bolshoydrug1/Remote_fly_ctrl/BOM_Remote_ctrl.xlsx

Reference | Qty | Value | DNP | Exclude from BOM | Exclude from Board | Footprint | Datasheet
C1 | 1 | 100u |  |  |  | Capacitor_SMD:C_Elec_6.3x7.7
C2,C3,C4,C5,C6,C7,C8,C9,C10,C11,C12,C14,C21,C22,C23,C24,C25,C26,C27,C28,C29,C30,C31,C32,C33,C34,C35,C36,C37,C38,C39,C40,C41,C42,C43,C44,C45,C46,C47,C48 | 40 | 0.1u |  |  |  | Capacitor_SMD:C_0805_2012Metric_Pad1.18x1.45mm_HandSolder
C15,C16,C18,C20 | 4 | 15p |  |  |  | Capacitor_SMD:C_0805_2012Metric_Pad1.18x1.45mm_HandSolder
C17,C19 | 2 | 2.2u |  |  |  | Capacitor_SMD:C_0805_2012Metric_Pad1.18x1.45mm_HandSolder
D1,D5 | 2 | SS32 |  |  |  | Diode_SMD:D_SMA | https://www.vishay.com/docs/88751/ss32.pdf
D2,D4,D6,D7 | 4 | SMAJ5.0CA |  |  |  | Diode_SMD:D_SMA | https://www.littelfuse.com/media?itemid=75e32973-b177-4ee3-a0ff-cedaf1abdb93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
D3 | 1 | LED |  |  |  | LED_THT:LED_D3.0mm_Clear
D9,D10 | 2 | LED |  |  |  | LED_SMD:LED_0805_2012Metric_Pad1.15x1.40mm_HandSolder
D11,D12,D13,D14,D15,D16,D17,D18,D19,D20 | 10 | LED |  |  |  | LED_THT:LED_D3.0mm
DD1 | 1 | BMP280 |  |  |  | Package_LGA:Bosch_LGA-8_2x2.5mm_P0.65mm_ClockwisePinNumbering | https://ae-bst.resource.bosch.com/media/_tech/media/datasheets/BST-BMP280-DS001.pdf
F1,F2 | 2 | MF-MSMF110-2 |  |  |  | Fuse:Fuse_1812_4532Metric_Pad1.30x3.40mm_HandSolder
J1 | 1 | USB_B_Mini |  |  |  | Connector_USB:USB_Mini-B_Lumberg_2486_01_Horizontal
J2 | 1 | Conn_01x03_Pin |  |  |  | Connector_JST:JST_NV_B03P-NV_1x03_P5.00mm_Vertical
J3 | 1 | Conn_01x03_Pin |  |  |  | Connector_PinHeader_2.54mm:PinHeader_1x03_P2.54mm_Vertical | do not install !!!
J4 | 1 | Conn_01x02_Pin |  |  |  | Connector_PinHeader_2.54mm:PinHeader_1x02_P2.54mm_Vertical | do not install !!!
J6,J8 | 2 | Conn_01x04_Pin |  |  |  | Connector_PinSocket_2.54mm:PinSocket_1x04_P2.54mm_Vertical
J7 | 1 | Conn_01x06_Pin |  |  |  | Connector_Hirose:Hirose_DF13-06P-1.25DSA_1x06_P1.25mm_Vertical
J9 | 1 | Conn_01x02_Pin |  |  |  | Connector_Hirose:Hirose_DF13-02P-1.25DSA_1x02_P1.25mm_Vertical
Q1 | 1 | AO3400A |  |  |  | Package_TO_SOT_SMD:SOT-23 | http://www.aosmd.com/pdfs/datasheet/AO3400A.pdf
R1,R5,R31,R32,R33,R34,R35,R36,R37,R38,R39,R40,R41,R42 | 14 | 100 |  |  |  | Resistor_SMD:R_0805_2012Metric_Pad1.20x1.40mm_HandSolder
R2,R7,R10,R11 | 4 | 10k |  |  |  | Resistor_SMD:R_0805_2012Metric_Pad1.20x1.40mm_HandSolder
R3,R4,R14,R17,R18 | 5 | 0 |  |  |  | Resistor_SMD:R_0805_2012Metric_Pad1.20x1.40mm_HandSolder
R12,R13 | 2 | 330 |  |  |  | Resistor_SMD:R_0805_2012Metric_Pad1.20x1.40mm_HandSolder
R15,R16,R19,R20 | 4 | 3k |  |  |  | Resistor_SMD:R_0805_2012Metric_Pad1.20x1.40mm_HandSolder
R21,R22,R23,R24,R25,R26,R27,R28,R29,R30 | 10 | 220 |  |  |  | Resistor_SMD:R_0805_2012Metric_Pad1.20x1.40mm_HandSolder
SW1,SW2,SW3,SW4,SW5,SW6,SW7,SW8,SW9,SW10,SW11,SW12 | 12 | SW_Push |  |  |  | Button_Switch_THT:SW_PUSH_6mm
U1 | 1 | AMS1117-3.3 |  |  |  | Package_TO_SOT_SMD:SOT-223-3_TabPin2 | http://www.advanced-monolithic.com/pdf/ds1117.pdf
U2 | 1 | SRV05-4 |  |  |  | Package_TO_SOT_SMD:SOT-23-6 | http://www.onsemi.com/pub/Collateral/SRV05-4-D.PDF
U3 | 1 | CH32V303VCT6 |  |  |  | Package_QFP:LQFP-100_14x14mm_P0.5mm | https://static.chipdip.ru/lib/164/DOC045164022.pdf
U4 | 1 | Ai-Thinker-Ra-01 |  |  |  | RF_Module:Ai-Thinker-Ra-01-LoRa | http://wiki.ai-thinker.com/_media/lora/docs/c047ps01a1_ra-01_product_specification_v1.1.pdf
U5 | 1 | AT24C256 |  |  |  | Package_SO:SOIC-8_3.9x4.9mm_P1.27mm | https://www.onsemi.cn/PowerSolutions/document/CAT24C256-D.PDF
U6 | 1 | Ai-Thinker-Ra-01SH |  |  |  | RF_Module:Ai-Thinker-Ra-01-LoRa | http://wiki.ai-thinker.com/_media/lora/docs/c047ps01a1_ra-01_product_specification_v1.1.pdf
U7,U8 | 2 | ULN2003 |  |  |  | Package_SO:SO-16_3.9x9.9mm_P1.27mm | http://www.ti.com/lit/ds/symlink/uln2003a.pdf
VD1,VD2,VD3,VD4,VD5,VD6,VD7,VD8,VD9,VD10,VD11 | 11 | GSOT03C-E3-08 |  |  |  | Package_TO_SOT_SMD:SOT-23 | https://www.chipdip.ru/product/gsot03c-e3-08-ustroystvo-zaschity-ot-esd-zaschitnyy-umw-9001633932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
Y1 | 1 | X322525MQB4SI |  |  |  | Oscillator:Oscillator_SMD_Abracon_ASE-4Pin_3.2x2.5mm | https://cdn.promelec.ru/upload/items/2023/03/10/YSX321SL.pdf
Y2 | 1 | SMD03215C2 |  |  |  | Crystal:Crystal_SMD_3215-2Pin_3.2x1.5mm | https://www.chipdip.ru/product/kvartsevyy-rezonator-32.768-kgts-korpus-smd03215c2-8010532234
