bolshoydrug1/Remote_fly_ctrl/(list of files, drawings)

Other design files:
freerouting.dsn
