bolshoydrug1/Remote_fly_ctrl/Magister_work_v1.kicad_pcb

## KiCad design Magister_work_v1.kicad_pcb (2026-10-15)

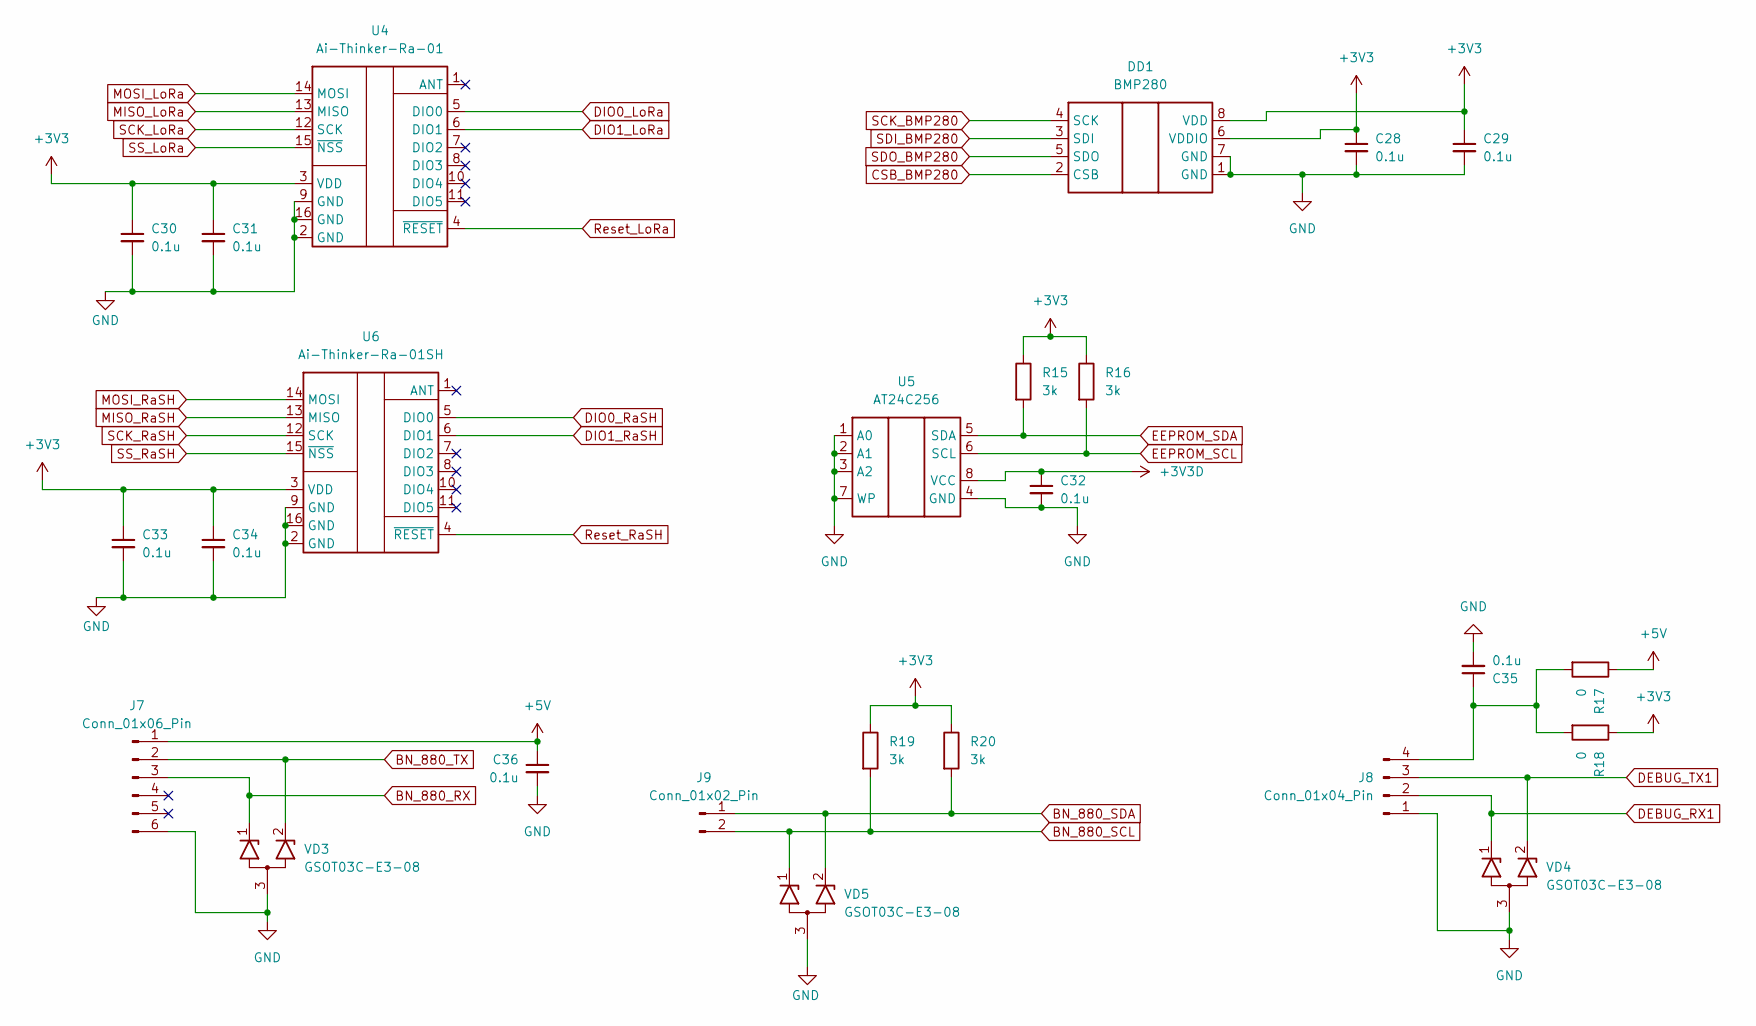
[picture p1: schematic Sensors_1.kicad_sch]

Parts:
C28, C29, C30, C31, C32, C33, C34, C35, C36: 0.1u; C_0805_2012Metric_Pad1.18x1.45mm_HandSolder
DD1: BMP280; Bosch_LGA-8_2x2.5mm_P0.65mm_ClockwisePinNumbering
J7: Conn_01x06_Pin; Hirose_DF13-06P-1.25DSA_1x06_P1.25mm_Vertical
J8: Conn_01x04_Pin; PinSocket_1x04_P2.54mm_Vertical
J9: Conn_01x02_Pin; Hirose_DF13-02P-1.25DSA_1x02_P1.25mm_Vertical
R15, R16, R19, R20: 3k; R_0805_2012Metric_Pad1.20x1.40mm_HandSolder
R17, R18: 0; R_0805_2012Metric_Pad1.20x1.40mm_HandSolder
U4: Ai-Thinker-Ra-01; Ai-Thinker-Ra-01-LoRa
U5: AT24C256; SOIC-8_3.9x4.9mm_P1.27mm
U6: Ai-Thinker-Ra-01SH; Ai-Thinker-Ra-01-LoRa
VD3, VD4, VD5: GSOT03C-E3-08; SOT-23

Connections:
+3V3: C28.1, C29.1, C30.1, C31.1, C32.1, C33.1, C34.1, DD1.6 (VDDIO), DD1.8 (VDD), R15.1, R16.1, R18.1, R19.1, R20.1, U4.3 (VDD), U5.8 (VCC), U6.3 (VDD); also elsewhere on the board
+5V: C36.1, J7.1, R17.1; also elsewhere on the board
BN_880_RX: J7.3, VD3.1 (K1); also elsewhere on the board
BN_880_SCL: J9.2, R19.2, VD5.1 (K1); also elsewhere on the board
BN_880_SDA: J9.1, R20.2, VD5.2 (K2); also elsewhere on the board
BN_880_TX: J7.2, VD3.2 (K2); also elsewhere on the board
CSB_BMP280: DD1.2 (CSB); also elsewhere on the board
DEBUG_RX1: J8.2, VD4.1 (K1); also elsewhere on the board
DEBUG_TX1: J8.3, VD4.2 (K2); also elsewhere on the board
DIO0_LoRa: U4.5 (DIO0); also elsewhere on the board
DIO0_RaSH: U6.5 (DIO0); also elsewhere on the board
DIO1_LoRa: U4.6 (DIO1); also elsewhere on the board
DIO1_RaSH: U6.6 (DIO1); also elsewhere on the board
EEPROM_SCL: R16.2, U5.6 (SCL); also elsewhere on the board
EEPROM_SDA: R15.2, U5.5 (SDA); also elsewhere on the board
GND: C28.2, C29.2, C30.2, C31.2, C32.2, C33.2, C34.2, C35.2, C36.2, DD1.1 (GND), DD1.7 (GND), J7.6, J8.1, U4.2 (GND), U4.9 (GND), U4.16 (GND), U5.1 (A0), U5.2 (A1), U5.3 (A2), U5.4 (GND), U5.7 (WP), U6.2 (GND), U6.9 (GND), U6.16 (GND), VD3.3 (A), VD4.3 (A), VD5.3 (A); also elsewhere on the board
MISO_LoRa: U4.13 (MISO); also elsewhere on the board
MISO_RaSH: U6.13 (MISO); also elsewhere on the board
MOSI_LoRa: U4.14 (MOSI); also elsewhere on the board
MOSI_RaSH: U6.14 (MOSI); also elsewhere on the board
unnamed: C35.1, J8.4, R17.2, R18.2
Reset_LoRa: U4.4 (~RESET); also elsewhere on the board
Reset_RaSH: U6.4 (~RESET); also elsewhere on the board
SCK_BMP280: DD1.4 (SCK); also elsewhere on the board
SCK_LoRa: U4.12 (SCK); also elsewhere on the board
SCK_RaSH: U6.12 (SCK); also elsewhere on the board
SDI_BMP280: DD1.3 (SDI); also elsewhere on the board
SDO_BMP280: DD1.5 (SDO); also elsewhere on the board
SS_LoRa: U4.15 (~NSS); also elsewhere on the board
SS_RaSH: U6.15 (~NSS); also elsewhere on the board

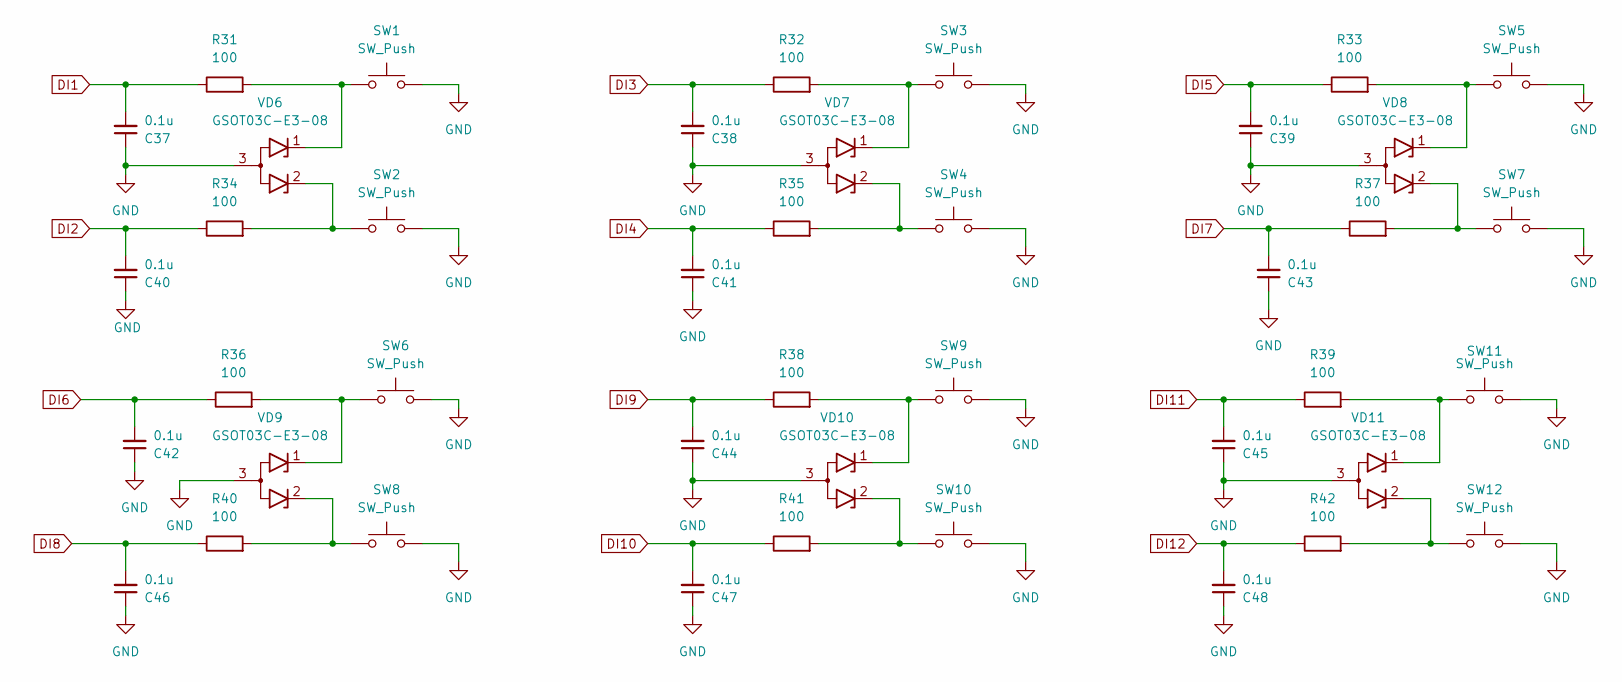
[picture p2: schematic External_interfaces.kicad_sch]

Parts:
C37, C38, C39, C40, C41, C42, C43, C44, C45, C46, C47, C48: 0.1u; C_0805_2012Metric_Pad1.18x1.45mm_HandSolder
R31, R32, R33, R34, R35, R36, R37, R38, R39, R40, R41, R42: 100; R_0805_2012Metric_Pad1.20x1.40mm_HandSolder
SW1, SW2, SW3, SW4, SW5, SW6, SW7, SW8, SW9, SW10, SW11, SW12: SW_Push; SW_PUSH_6mm
VD6, VD7, VD8, VD9, VD10, VD11: GSOT03C-E3-08; SOT-23

Connections:
DI1: C37.2, R31.1; also elsewhere on the board
DI2: C40.2, R34.1; also elsewhere on the board
DI3: C38.2, R32.1; also elsewhere on the board
DI4: C41.2, R35.1; also elsewhere on the board
DI5: C39.2, R33.1; also elsewhere on the board
DI6: C42.2, R36.1; also elsewhere on the board
DI7: C43.2, R37.1; also elsewhere on the board
DI8: C46.2, R40.1; also elsewhere on the board
DI9: C44.2, R38.1; also elsewhere on the board
DI10: C47.2, R41.1; also elsewhere on the board
DI11: C45.2, R39.1; also elsewhere on the board
DI12: C48.2, R42.1; also elsewhere on the board
GND: C37.1, C38.1, C39.1, C40.1, C41.1, C42.1, C43.1, C44.1, C45.1, C46.1, C47.1, C48.1, SW1.2, SW2.2, SW3.2, SW4.2, SW5.2, SW6.2, SW7.2, SW8.2, SW9.2, SW10.2, SW11.2, SW12.2, VD6.3 (A), VD7.3 (A), VD8.3 (A), VD9.3 (A), VD10.3 (A), VD11.3 (A); also elsewhere on the board
unnamed: R31.2, SW1.1, VD6.1 (K1)
unnamed: R34.2, SW2.1, VD6.2 (K2)
unnamed: R32.2, SW3.1, VD7.1 (K1)
unnamed: R35.2, SW4.1, VD7.2 (K2)
unnamed: R33.2, SW5.1, VD8.1 (K1)
unnamed: R37.2, SW7.1, VD8.2 (K2)
unnamed: R36.2, SW6.1, VD9.1 (K1)
unnamed: R40.2, SW8.1, VD9.2 (K2)
unnamed: R38.2, SW9.1, VD10.1 (K1)
unnamed: R41.2, SW10.1, VD10.2 (K2)
unnamed: R39.2, SW11.1, VD11.1 (K1)
unnamed: R42.2, SW12.1, VD11.2 (K2)

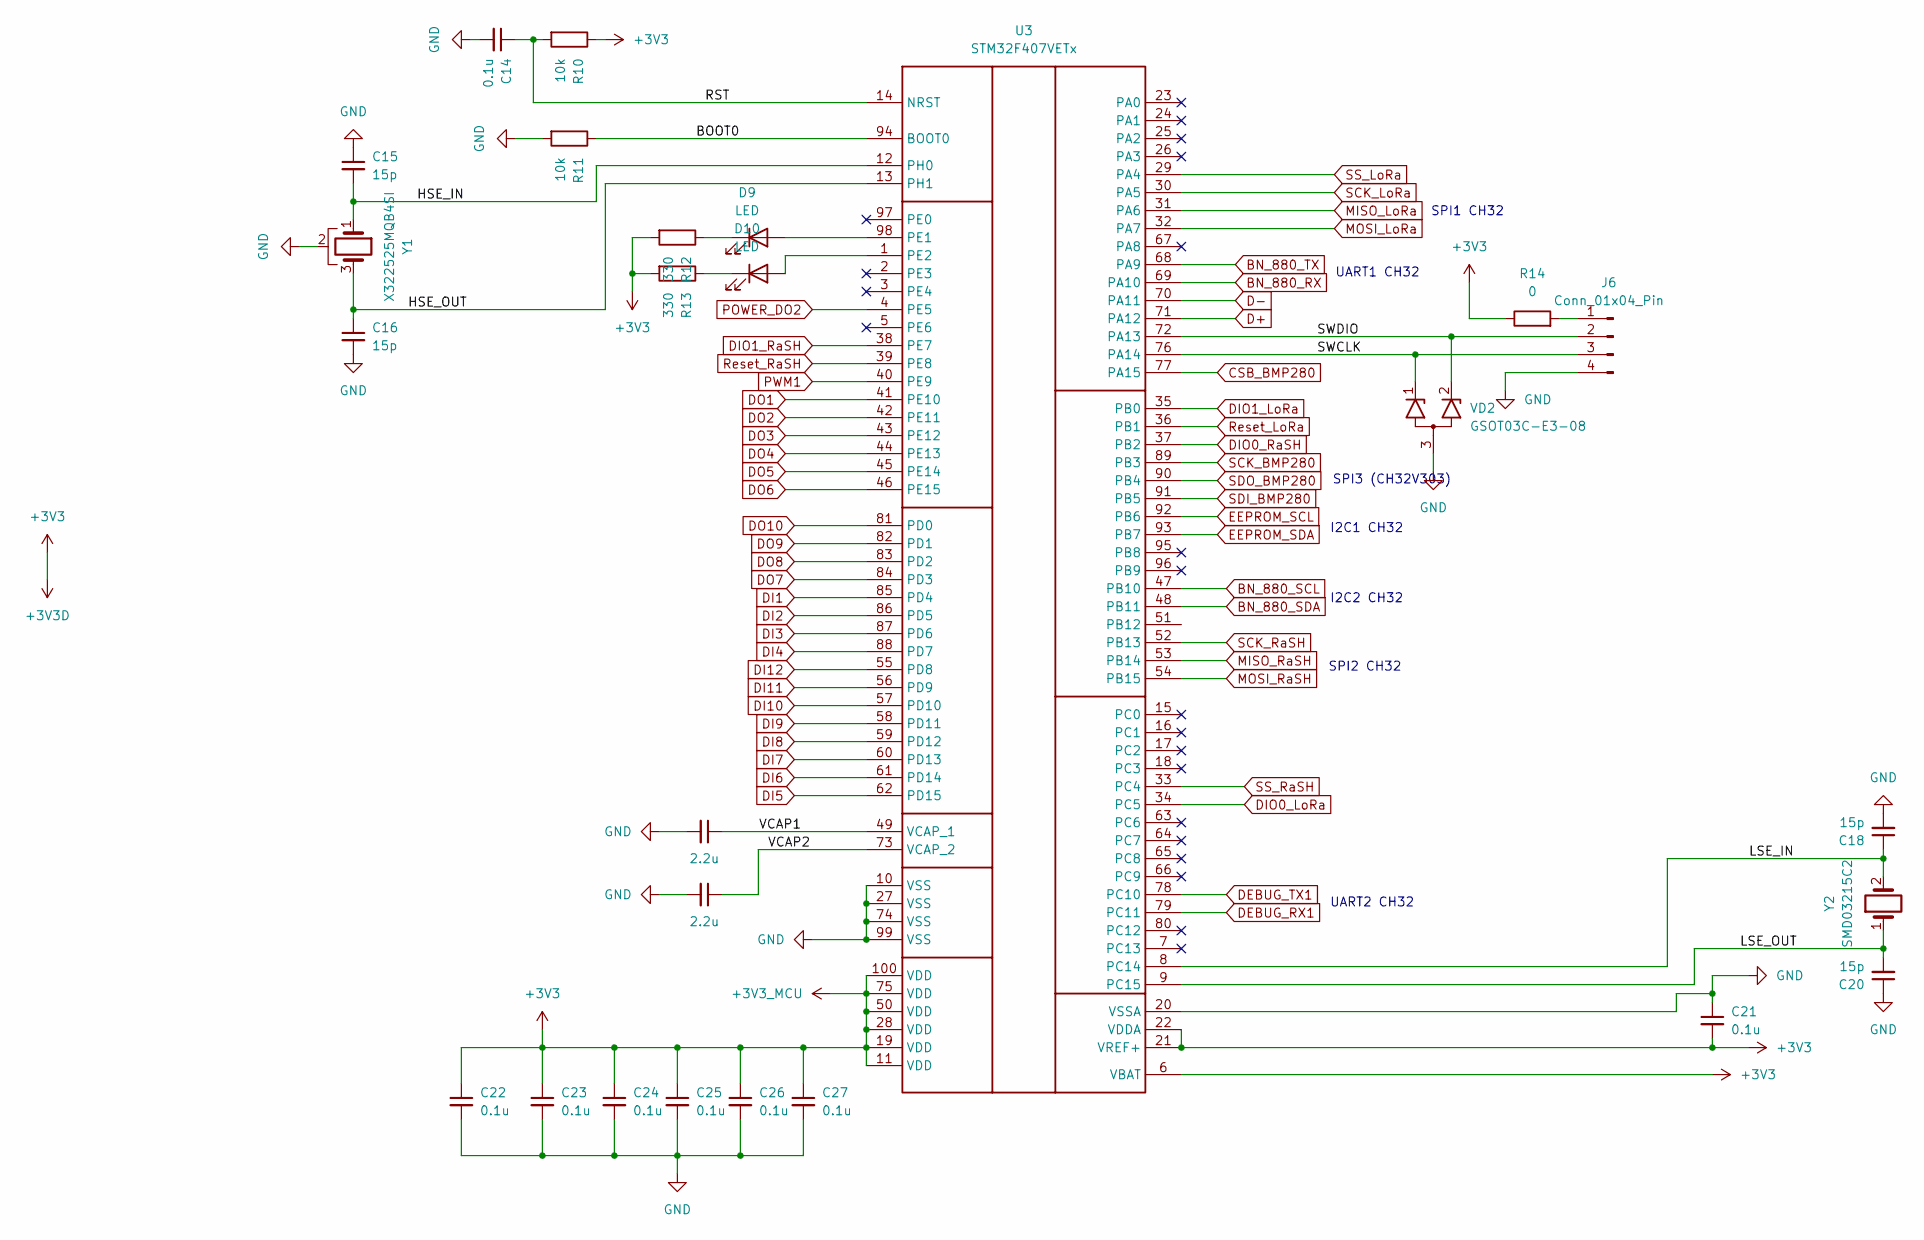
[picture p3: schematic STMF401.kicad_sch]

Parts:
C14, C21, C22, C23, C24, C25, C26, C27: 0.1u; C_0805_2012Metric_Pad1.18x1.45mm_HandSolder
C15, C16, C18, C20: 15p; C_0805_2012Metric_Pad1.18x1.45mm_HandSolder
C17, C19: 2.2u; C_0805_2012Metric_Pad1.18x1.45mm_HandSolder
D9, D10: LED; LED_0805_2012Metric_Pad1.15x1.40mm_HandSolder
J6: Conn_01x04_Pin; PinSocket_1x04_P2.54mm_Vertical
R10, R11: 10k; R_0805_2012Metric_Pad1.20x1.40mm_HandSolder
R12, R13: 330; R_0805_2012Metric_Pad1.20x1.40mm_HandSolder
R14: 0; R_0805_2012Metric_Pad1.20x1.40mm_HandSolder
U3: STM32F407VETx; LQFP-100_14x14mm_P0.5mm
VD2: GSOT03C-E3-08; SOT-23
Y1: X322525MQB4SI; Oscillator_SMD_Abracon_ASE-4Pin_3.2x2.5mm
Y2: SMD03215C2; Crystal_SMD_3215-2Pin_3.2x1.5mm

Connections:
+3V3: C21.2, C22.1, C23.1, C24.1, C25.1, C26.1, C27.1, R10.1, R12.2, R13.2, R14.1, U3.6 (VBAT), U3.11 (VDD), U3.19 (VDD), U3.21 (VREF+), U3.22 (VDDA), U3.28 (VDD), U3.50 (VDD), U3.75 (VDD), U3.100 (VDD); also elsewhere on the board
/STMF401_Sheet/BOOT0: R11.1, U3.94 (BOOT0)
/STMF401_Sheet/HSE_IN: C15.2, U3.12 (PH0), Y1.1 (OSC)
/STMF401_Sheet/HSE_OUT: C16.1, U3.13 (PH1), Y1.3 (OSC)
/STMF401_Sheet/LSE_IN: C18.1, U3.8 (PC14), Y2.2 (OSC)
/STMF401_Sheet/LSE_OUT: C20.2, U3.9 (PC15), Y2.1 (OSC)
/STMF401_Sheet/RST: C14.1, R10.2, U3.14 (NRST)
/STMF401_Sheet/SWCLK: J6.3, U3.76 (PA14), VD2.1 (K1)
/STMF401_Sheet/SWDIO: J6.2, U3.72 (PA13), VD2.2 (K2)
/STMF401_Sheet/VCAP1: C17.1, U3.49 (VCAP_1)
/STMF401_Sheet/VCAP2: C19.1, U3.73 (VCAP_2)
BN_880_RX: U3.69 (PA10); also elsewhere on the board
BN_880_SCL: U3.47 (PB10); also elsewhere on the board
BN_880_SDA: U3.48 (PB11); also elsewhere on the board
BN_880_TX: U3.68 (PA9); also elsewhere on the board
CSB_BMP280: U3.77 (PA15); also elsewhere on the board
D+: U3.71 (PA12); also elsewhere on the board
D-: U3.70 (PA11); also elsewhere on the board
DEBUG_RX1: U3.79 (PC11); also elsewhere on the board
DEBUG_TX1: U3.78 (PC10); also elsewhere on the board
DI1: U3.85 (PD4); also elsewhere on the board
DI2: U3.86 (PD5); also elsewhere on the board
DI3: U3.87 (PD6); also elsewhere on the board
DI4: U3.88 (PD7); also elsewhere on the board
DI5: U3.62 (PD15); also elsewhere on the board
DI6: U3.61 (PD14); also elsewhere on the board
DI7: U3.60 (PD13); also elsewhere on the board
DI8: U3.59 (PD12); also elsewhere on the board
DI9: U3.58 (PD11); also elsewhere on the board
DI10: U3.57 (PD10); also elsewhere on the board
DI11: U3.56 (PD9); also elsewhere on the board
DI12: U3.55 (PD8); also elsewhere on the board
DIO0_LoRa: U3.34 (PC5); also elsewhere on the board
DIO0_RaSH: U3.37 (PB2); also elsewhere on the board
DIO1_LoRa: U3.35 (PB0); also elsewhere on the board
DIO1_RaSH: U3.38 (PE7); also elsewhere on the board
DO1: U3.41 (PE10); also elsewhere on the board
DO2: U3.42 (PE11); also elsewhere on the board
DO3: U3.43 (PE12); also elsewhere on the board
DO4: U3.44 (PE13); also elsewhere on the board
DO5: U3.45 (PE14); also elsewhere on the board
DO6: U3.46 (PE15); also elsewhere on the board
DO7: U3.84 (PD3); also elsewhere on the board
DO8: U3.83 (PD2); also elsewhere on the board
DO9: U3.82 (PD1); also elsewhere on the board
DO10: U3.81 (PD0); also elsewhere on the board
EEPROM_SCL: U3.92 (PB6); also elsewhere on the board
EEPROM_SDA: U3.93 (PB7); also elsewhere on the board
GND: C14.2, C15.1, C16.2, C17.2, C18.2, C19.2, C20.1, C21.1, C22.2, C23.2, C24.2, C25.2, C26.2, C27.2, J6.4, R11.2, U3.10 (VSS), U3.20 (VSSA), U3.27 (VSS), U3.74 (VSS), U3.99 (VSS), VD2.3 (A), Y1.2 (GND), Y1.4 (GND); also elsewhere on the board
MISO_LoRa: U3.31 (PA6); also elsewhere on the board
MISO_RaSH: U3.53 (PB14); also elsewhere on the board
MOSI_LoRa: U3.32 (PA7); also elsewhere on the board
MOSI_RaSH: U3.54 (PB15); also elsewhere on the board
unnamed: D9.2 (A), U3.98 (PE1)
unnamed: D9.1 (K), R12.1
unnamed: D10.2 (A), U3.1 (PE2)
unnamed: D10.1 (K), R13.1
unnamed: J6.1, R14.2
POWER_DO2: U3.4 (PE5); also elsewhere on the board
PWM1: U3.40 (PE9); also elsewhere on the board
Reset_LoRa: U3.36 (PB1); also elsewhere on the board
Reset_RaSH: U3.39 (PE8); also elsewhere on the board
SCK_BMP280: U3.89 (PB3); also elsewhere on the board
SCK_LoRa: U3.30 (PA5); also elsewhere on the board
SCK_RaSH: U3.52 (PB13); also elsewhere on the board
SDI_BMP280: U3.91 (PB5); also elsewhere on the board
SDO_BMP280: U3.90 (PB4); also elsewhere on the board
SS_LoRa: U3.29 (PA4); also elsewhere on the board
SS_RaSH: U3.33 (PC4); also elsewhere on the board

Notes on the sheet:
SPI1 CH32
SPI3 (CH32V303)
SPI2 CH32
I2C1 CH32
UART1 CH32
UART2 CH32
I2C2 CH32

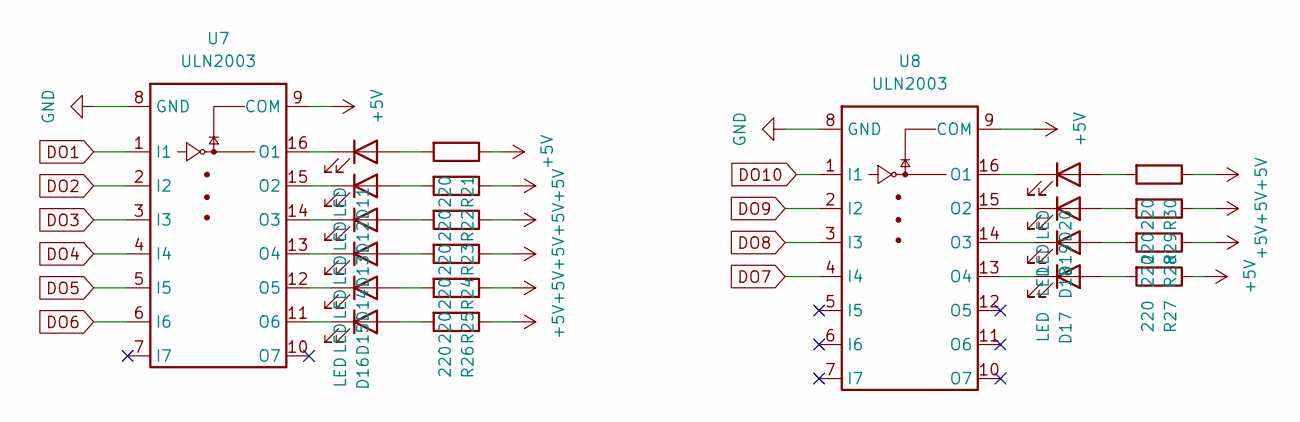
[picture p4: schematic PWM_out.kicad_sch]

Parts:
D11, D12, D13, D14, D15, D16, D17, D18, D19, D20: LED; LED_D3.0mm
R21, R22, R23, R24, R25, R26, R27, R28, R29, R30: 220; R_0805_2012Metric_Pad1.20x1.40mm_HandSolder
U7, U8: ULN2003; SO-16_3.9x9.9mm_P1.27mm

Connections:
+5V: R21.1, R22.1, R23.1, R24.1, R25.1, R26.1, R27.1, R28.1, R29.1, R30.1, U7.9 (COM), U8.9 (COM); also elsewhere on the board
DO1: U7.1 (I1); also elsewhere on the board
DO2: U7.2 (I2); also elsewhere on the board
DO3: U7.3 (I3); also elsewhere on the board
DO4: U7.4 (I4); also elsewhere on the board
DO5: U7.5 (I5); also elsewhere on the board
DO6: U7.6 (I6); also elsewhere on the board
DO7: U8.4 (I4); also elsewhere on the board
DO8: U8.3 (I3); also elsewhere on the board
DO9: U8.2 (I2); also elsewhere on the board
DO10: U8.1 (I1); also elsewhere on the board
GND: U7.8 (GND), U8.8 (GND); also elsewhere on the board
unnamed: D11.2 (A), R21.2
unnamed: D11.1 (K), U7.16 (O1)
unnamed: D12.2 (A), R22.2
unnamed: D12.1 (K), U7.15 (O2)
unnamed: D13.2 (A), R23.2
unnamed: D13.1 (K), U7.14 (O3)
unnamed: D14.2 (A), R24.2
unnamed: D14.1 (K), U7.13 (O4)
unnamed: D15.2 (A), R25.2
unnamed: D15.1 (K), U7.12 (O5)
unnamed: D16.2 (A), R26.2
unnamed: D16.1 (K), U7.11 (O6)
unnamed: D17.2 (A), R27.2
unnamed: D17.1 (K), U8.13 (O4)
unnamed: D18.2 (A), R28.2
unnamed: D18.1 (K), U8.14 (O3)
unnamed: D19.2 (A), R29.2
unnamed: D19.1 (K), U8.15 (O2)
unnamed: D20.2 (A), R30.2
unnamed: D20.1 (K), U8.16 (O1)

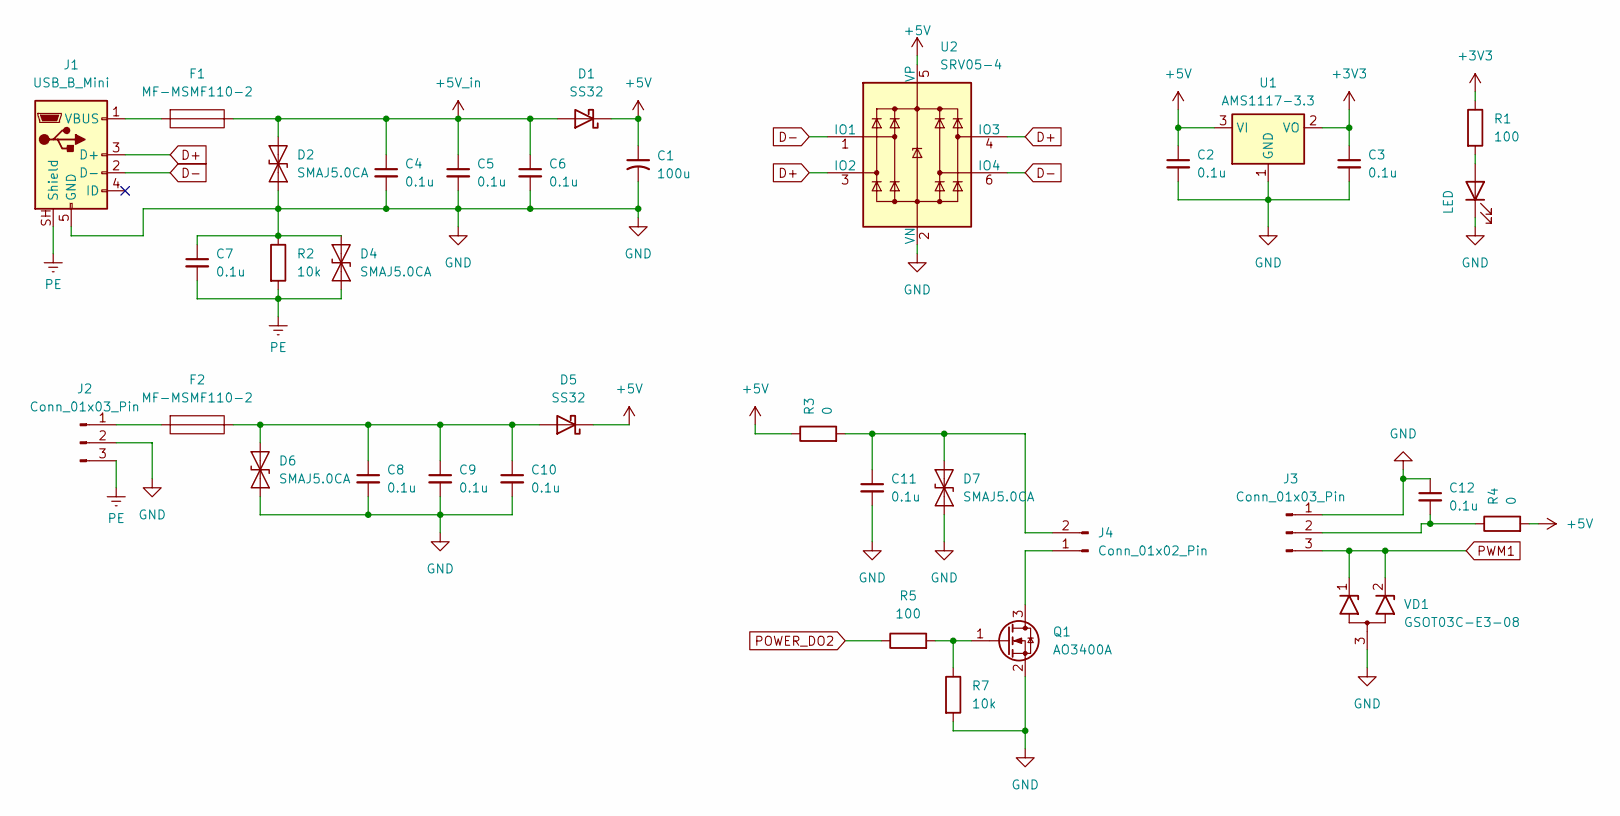
[picture p5: schematic PWR.kicad_sch]

Parts:
C1: 100u; C_Elec_6.3x7.7
C2, C3, C4, C5, C6, C7, C8, C9, C10, C11, C12: 0.1u; C_0805_2012Metric_Pad1.18x1.45mm_HandSolder
D1, D5: SS32; D_SMA
D2, D4, D6, D7: SMAJ5.0CA; D_SMA
D3: LED; LED_D3.0mm_Clear
F1, F2: MF-MSMF110-2; Fuse_1812_4532Metric_Pad1.30x3.40mm_HandSolder
J1: USB_B_Mini; USB_Mini-B_Lumberg_2486_01_Horizontal
J2: Conn_01x03_Pin; JST_NV_B03P-NV_1x03_P5.00mm_Vertical
J3: Conn_01x03_Pin; PinHeader_1x03_P2.54mm_Vertical
J4: Conn_01x02_Pin; PinHeader_1x02_P2.54mm_Vertical
Q1: AO3400A; SOT-23
R1, R5: 100; R_0805_2012Metric_Pad1.20x1.40mm_HandSolder
R2, R7: 10k; R_0805_2012Metric_Pad1.20x1.40mm_HandSolder
R3, R4: 0; R_0805_2012Metric_Pad1.20x1.40mm_HandSolder
U1: AMS1117-3.3; SOT-223-3_TabPin2
U2: SRV05-4; SOT-23-6
VD1: GSOT03C-E3-08; SOT-23

Connections:
+3V3: C3.1, R1.1, U1.2 (VO); also elsewhere on the board
+5V: C1.1, C2.1, D1.1 (K), D5.1 (K), R3.1, R4.2, U1.3 (VI), U2.5 (VP); also elsewhere on the board
+5V_in: C4.1, C5.1, C6.1, D1.2 (A), D2.2 (A2), F1.2 (A2)
D+: J1.3 (D+), U2.3 (IO2), U2.4 (IO3); also elsewhere on the board
D-: J1.2 (D-), U2.1 (IO1), U2.6 (IO4); also elsewhere on the board
GND: C1.2, C2.2, C3.2, C4.2, C5.2, C6.2, C7.1, C8.2, C9.2, C10.2, C11.2, C12.1, D2.1 (A1), D3.1 (K), D4.2 (A2), D6.1 (A1), D7.1 (A1), J1.5 (GND), J2.2, J3.1, Q1.2 (S), R2.1, R7.2, U1.1 (GND), U2.2 (VN), VD1.3 (A); also elsewhere on the board
unnamed: D3.2 (A), R1.2
unnamed: C8.1, C9.1, C10.1, D5.2 (A), D6.2 (A2), F2.2 (A2)
unnamed: C11.1, D7.2 (A2), J4.2, R3.2
unnamed: F1.1 (A1), J1.1 (VBUS)
unnamed: F2.1 (A1), J2.1
unnamed: C12.2, J3.2, R4.1
unnamed: J4.1, Q1.3 (D)
unnamed: Q1.1 (G), R5.2, R7.1
PE: C7.2, D4.1 (A1), J1.SH (Shield), J2.3, R2.2
POWER_DO2: R5.1; also elsewhere on the board
PWM1: J3.3, VD1.1 (K1), VD1.2 (K2); also elsewhere on the board

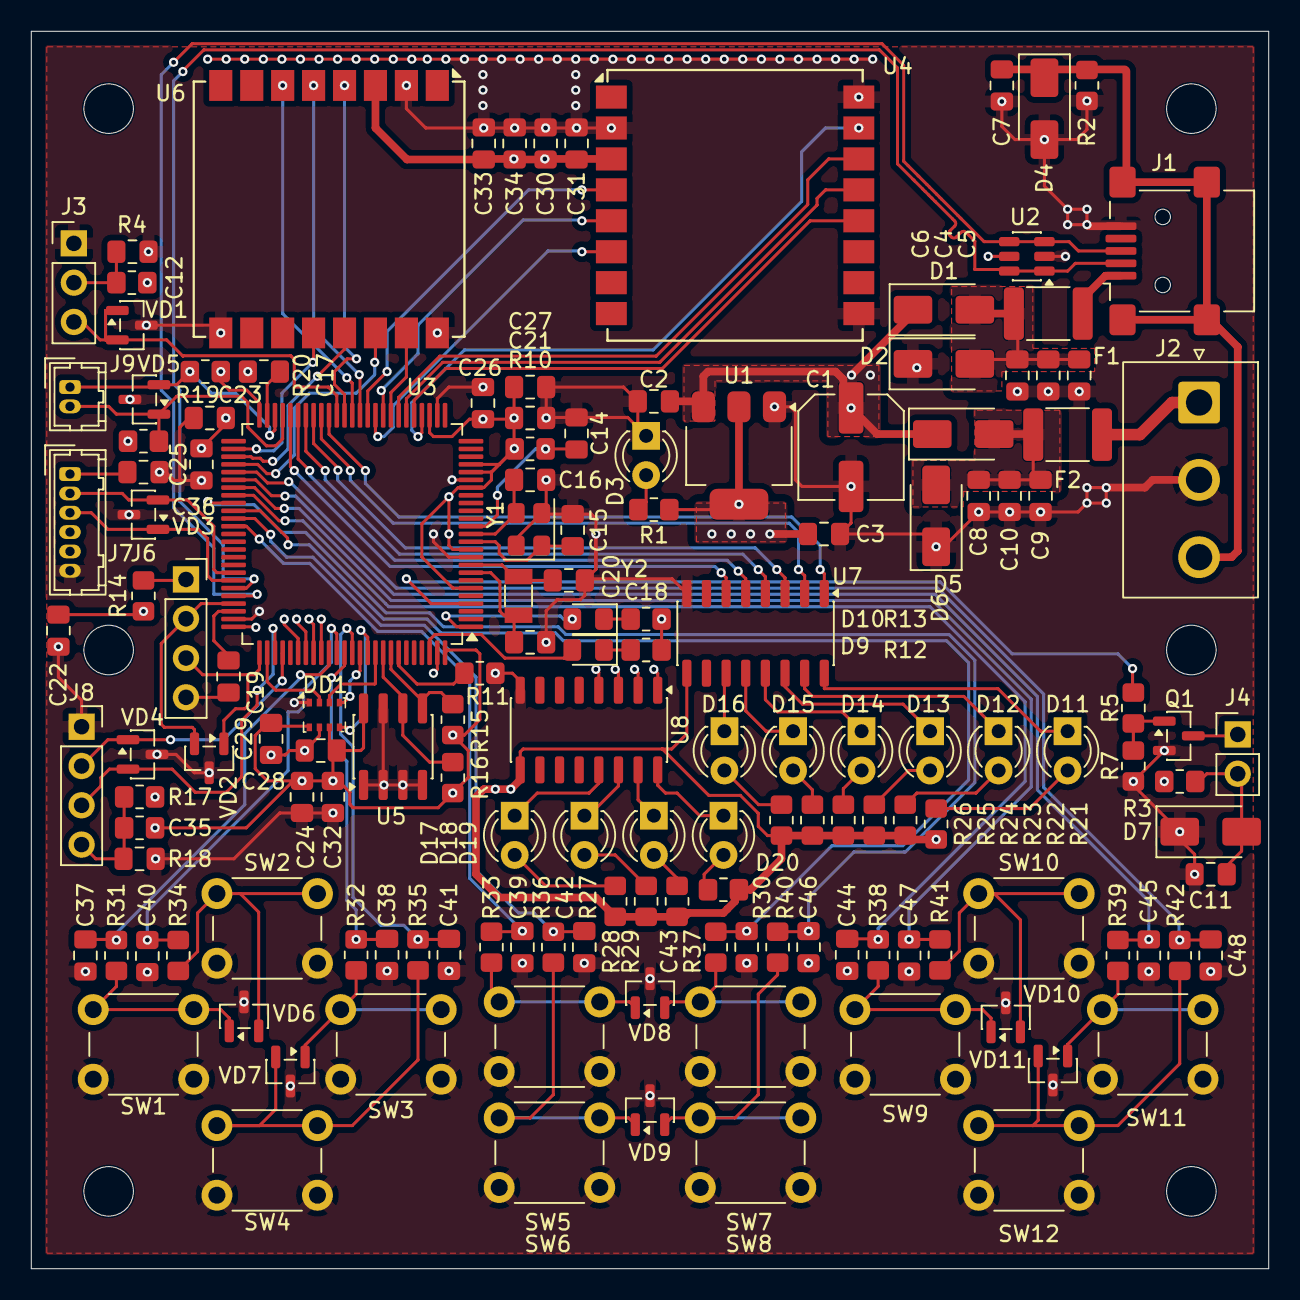
[picture p6: board Magister_work_v1.kicad_pcb from above]

Board: 4 copper layers, 80.0 x 80.0 mm, 150 parts (0 on the bottom side), 113 nets.
