bolshoydrug1/Remote_fly_ctrl/(commit log)

2026-09-14 initial commitначата работа над пультом для дистанционного управления квадракоптером для магистерского проекта
    [External_interfaces.kicad_sch, Magister_work_v1.kicad_pcb, Magister_work_v1.kicad_sch, PWM_out.kicad_sch, PWR.kicad_sch, STMF401.kicad_sch, Sensors.kicad_sch, Sensors_1.kicad_sch]
2026-09-15 feat: начал работу над проектом пульта управления, продумана входная цепь питания устройства
    [PWR.kicad_sch]
2026-09-15 feat: добавлен верный разъём USB
    [PWR.kicad_sch]
2026-09-16 feat: добавлена цепь питания и заряда батареи для аварийного питания
    [Magister_work_v1-B_Cu.gbr, Magister_work_v1-B_Mask.gbr, Magister_work_v1-B_Paste.gbr, Magister_work_v1-B_Silkscreen.gbr, Magister_work_v1-Edge_Cuts.gbr, Magister_work_v1-F_Cu.gbr, Magister_work_v1-F_Mask.gbr, Magister_work_v1-F_Paste.gbr]
2026-09-21 feat:убрал часть с батарейным питанием, убрал лишние элементы со старого проекта
    [External_interfaces.kicad_sch, Magister_work_v1.kicad_pcb, Magister_work_v1.kicad_sch, PWM_out.kicad_sch, PWR.kicad_sch, STMF401.kicad_sch, Sensors_1.kicad_sch]
2026-09-22 feaat: добавлены светодиоды, кнопки и недостающие элементы защиты питания
    [External_interfaces.kicad_sch, Magister_work_v1.kicad_pcb, PWM_out.kicad_sch, PWR.kicad_sch, Sensors_1.kicad_sch]
2026-09-22 feat: добавлены глобальные линии связи, удалены линии связи со старого проекта
    [External_interfaces.kicad_sch, PWM_out.kicad_sch, PWR.kicad_sch, STMF401.kicad_sch, Sensors_1.kicad_sch]
2026-09-23 feat: добавлены светодиоды
    [PWM_out.kicad_sch, STMF401.kicad_sch]
2026-09-23 feat: добавлены связи цифровых линий с МК
    [Magister_work_v1.kicad_pcb, PWR.kicad_sch, STMF401.kicad_sch]
2026-09-24 feat: добавлен дополнительный разъём для питания
    [Magister_work_v1.kicad_pcb, PWR.kicad_sch]
2026-09-25 feat: укомплектовал основные узлы модуля на печатной платы для первичной компановки
    [Magister_work_v1.kicad_pcb]
2026-09-29 feat: расположены основные узлы модуля на печатной плате
    [External_interfaces.kicad_sch, Magister_work_v1.kicad_pcb, PWM_out.kicad_sch, PWR.kicad_sch, STMF401.kicad_sch, Sensors_1.kicad_sch]
2026-09-30 feat: добавлена микросхема для коммутации светодиодов
    [External_interfaces.kicad_sch, Magister_work_v1.kicad_pcb, PWM_out.kicad_sch]
2026-10-01 feat: добавлены соединения светодиодов и защитных диодов и кнопок
    [External_interfaces.kicad_sch, Magister_work_v1.kicad_pcb]
2026-10-02 feat: добавлена обвязка внешних интерфейсов
    [Magister_work_v1.kicad_pcb, PWR.kicad_sch, Sensors_1.kicad_sch]
2026-10-05 feat: разведена обвыязка кнопок
    [External_interfaces.kicad_sch, Magister_work_v1.kicad_pcb]
2026-10-06 feat: размешены все компоненты на печатной плате
    [Magister_work_v1.kicad_pcb, STMF401.kicad_sch, Sensors_1.kicad_sch]
2026-10-07 feat: начата разводка сигнальных линий и линий питания
    [Magister_work_v1.kicad_pcb, STMF401.kicad_sch]
2026-10-08 feat: проведены сигнальные линии ко всем UART и USB
    [Magister_work_v1.kicad_pcb, STMF401.kicad_sch]
2026-10-09 feat: разведены сигналньные линии для приёмо-передатчиков LoRa и LoRa_SH
    [Magister_work_v1.kicad_pcb, STMF401.kicad_sch]
2026-10-09 feat: разведены линии DI большая часть
    [External_interfaces.kicad_sch, Magister_work_v1.kicad_pcb, STMF401.kicad_sch]
2026-10-10 feat: первая версия проекта,разведены все дорожки
    [External_interfaces.kicad_sch, Magister_work_v1.kicad_pcb]
2026-10-12 feat: подготовлены все файлы для производства
2026-10-15 feat: отовая первая версия модуля приёмо-передатчика для полётного контроллера
